windsorschmidt/kicad-library-win/README.md

# kicad-library-win
A collection of schematic symbols and PCB footprints for use with KiCad
