windsorschmidt/kicad-library-win/(commit log)

2015-10-31 added LGA-12 footprint for LIS2HH12
2015-11-13 added footprint for AMS002 bluetooth module
2015-11-30 adding footprints
2015-11-30 fix pin numbers on ASPI-0630LR
2015-11-30 added project file to make editing or adding new footprints and symbols easier
    [kicad-library-win.kicad_pcb, kicad-library-win.sch]
2015-12-02 added some footprints for evac. deleted a couple of silly ones
2015-12-12 added symbol for molex micro fit connector
2015-12-12 added symbol for molex mini fit jr. connector
2015-12-15 added schematic symbol and footprint for VoCore v1.0
2016-04-03 added symbol: STM32F042K6T6
2016-04-05 added footprints
2016-04-14 added symbol: unshielded RJ45 connector
2016-04-14 add symbol: STM32F042C6T6
2016-04-17 added PTC footprint
2016-04-17 added footprint for TLC5947
2016-04-18 added symbol: screw hole
2016-04-25 added footprint for 4.2MM SMD inductor
2016-04-25 added footprint: 10-pin MSOP with thermal pad
2016-04-26 added footprint: molex micro-clasp 24-circuit right-angle receptacle
2016-04-28 fix pin numbering
2016-04-28 renamed Wurth RJ45 connector. updated 24-circuit Molex microclasp connector
2016-05-15 added symbols for dual diodes. added footprint for cem-1203(42) pcb-mount speaker
2016-05-16 add symbol: MUN5233DW1 dual NPN bias resistor
2016-05-29 add symbol for CAT4016 LED driver
2016-05-29 added symbol for ACSA08-51SEKWA 7-segment LED
2016-06-03 adding footprints for evac-dash
2016-06-03 added footprint for PLCC-2 LED
2016-06-04 footprint tweaks
2016-06-04 copy some standard library footprints to use a modified silkscreen
2016-07-11 added footprint for Ebay LCD display (WIP)
2017-02-09 add SV650 instrument cluster connector symbol
2017-05-02 add symbols and footprints
2017-09-28 add footprint: Soberton SP-1605
2017-09-28 Add footprint and 3D model: Molex 105017-0001
2018-03-06 add stm32f446
2018-10-12 new footprints
2018-11-06 footprints for OLED display and enclosures
2019-05-08 add footprints
2020-04-28 update vertical JAE connector
2020-04-28 add E-Switch TL9210
